JurecekLukas/Bluetooth_Reproduktor/foto/2.jpg

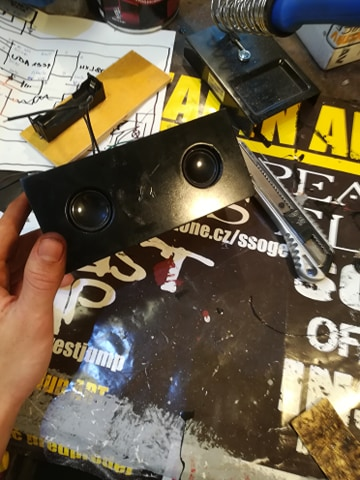
foto/2.jpg
