JurecekLukas/Bluetooth_Reproduktor/foto/1.jpg

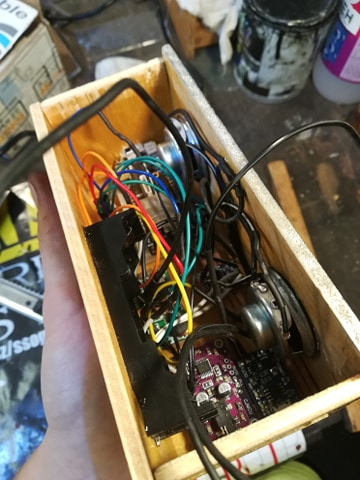
foto/1.jpg
