JurecekLukas/Bluetooth_Reproduktor/README.md

# Wifi rádio
Projekt 

Co to má umět - připojit se na internetový stream a přehrávat hudbu
              - Mít externí napájení + nabíjení
              - Stereo zvuk
              - Display na výpis aktuální písničky
              - Otáčecí enkodér na změnu zvuku 
              - popřípadě přepínání na BT Speaker

Nejspíš tyto odkazy BT---https://hackaday.io/project/168354-esp32-based-internet-radio-and-bluetooth-speaker/details
                  první provedení - indoš ----https://www.youtube.com/watch?v=Q-f93TD4EbY
                                  -  
                                  
                 esp/mobil ----- https://www.youtube.com/watch?v=RStncO3zb8g

Použití na Wifi rádio - https://www.youtube.com/watch?v=3ao87AgZ7Bc
                      - https://create.arduino.cc/projecthub/vandenbrande/arduino-rotary-encoder-simple-example-ky-040-b78752
                      - https://cdn-learn.adafruit.com/downloads/pdf/adafruit-i2s-stereo-decoder-uda1334a.pdf

https://docs.google.com/spreadsheets/d/1FWioxnjcoH0sdo3q8OV2s2G3TmypAP_5tfdtsYCqVy4/edit?usp=sharing

    ^
    
    |
    
    |
    
    |
    
odkaz na tabulku s hodnocením

jiný dac --- https://arduino-shop.cz/arduino/34412-i2s-pcm5102a-dac-audio-prevodnik.html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

Stereo zesilovač -- https://www.laskarduino.cz/2x3w-digitalni-audio-zesilovac-pam8403/

display -- https://www.laskarduino.cz/16x2-lcd-displej-1602-zeleny-i2c-prevodnik/

   esp32 board---https://www.aliexpress.com/item/32883116057.html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,searchweb201602_,searchweb201603_

   DAC dekodér---https://www.aliexpress.com/item/4000436992317.html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,searchweb201602_,searchweb201603_

   nabíjecí modul---https://www.aliexpress.com/item/33007359552.html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,searchweb201602_,searchweb201603_

   amplifiér----https://www.aliexpress.com/item/4000126984545.html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,searchweb201602_,searchweb201603_

   otáčecí nastavovací tlačítko----https://www.aliexpress.com/item/32462116984.html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,searchweb201602_,searchweb201603_

   power button s ledkou----https://www.aliexpress.com/item/32993978881.html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,searchweb201602_,searchweb201603_

   5v convertor + 3,3 convertor----https://www.aliexpress.com/item/33034117996.html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,searchweb201602_,searchweb201603_

   baterka----https://www.tipa.eu/cz/baterie-nabijeci-li-ion-18650-37v-2900mah-3c-motoma/d-209550/
   držák------https://www.tipa.eu/cz/pouzdro-baterie-clanku-18650-do-plosneho-spoje/d-199531/

   samotný reproduktor---https://www.aliexpress.com/item/32920881238.html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,searchweb201602_,searchweb201603_

   odpor----https://www.tipa.eu/cz/rezistor-100r-tr212-0125w/d-89863/
