JurecekLukas/Bluetooth_Reproduktor/foto/3.jpg

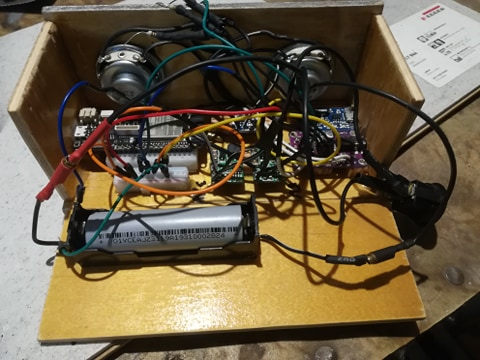
foto/3.jpg
